budulinek/arduino-sensors-udp-gateway/arduino-sensors-udp-gateway/07-interfaces.ino

/**************************************************************************/
/*!
  @brief Initiates ethernet interface, if DHCP enabled, gets IP from DHCP,
  starts all servers (UDP, web server).
*/
/**************************************************************************/
void startEthernet() {
  if (ETH_RESET_PIN != 0) {
    pinMode(ETH_RESET_PIN, OUTPUT);
    digitalWrite(ETH_RESET_PIN, LOW);
    delay(25);
    digitalWrite(ETH_RESET_PIN, HIGH);
    delay(ETH_RESET_DELAY);
  }
#ifdef ENABLE_DHCP
  if (data.config.enableDhcp) {
    dhcpSuccess = Ethernet.begin(data.mac);
  }
  if (!data.config.enableDhcp || dhcpSuccess == false) {
    Ethernet.begin(data.mac, data.config.ip, data.config.dns, data.config.gateway, data.config.subnet);
  }
#else  /* ENABLE_DHCP */
  Ethernet.begin(data.mac, data.config.ip, {}, data.config.gateway, data.config.subnet);  // No DNS
#endif /* ENABLE_DHCP */
  W5100.setRetransmissionTime(TCP_RETRANSMISSION_TIMEOUT);
  W5100.setRetransmissionCount(TCP_RETRANSMISSION_COUNT);
  webServer = EthernetServer(data.config.webPort);
  Udp.begin(data.config.udpPort);
  webServer.begin();
#if MAX_SOCK_NUM > 4
  if (W5100.getChip() == 51) maxSockNum = 4;  // W5100 chip never supports more than 4 sockets
#endif
}

/**************************************************************************/
/*!
  @brief Resets Arduino (works only on AVR chips).
*/
/**************************************************************************/
void (*resetFunc)(void) = 0;  //declare reset function at address 0

/**************************************************************************/
/*!
  @brief Maintains DHCP lease.
*/
/**************************************************************************/
#ifdef ENABLE_DHCP
void maintainDhcp() {
  if (data.config.enableDhcp && dhcpSuccess == true) {  // only call maintain if initial DHCP request by startEthernet was successfull
    Ethernet.maintain();
  }
}
#endif /* ENABLE_DHCP */

/**************************************************************************/
/*!
  @brief Generate random MAC using pseudo random generator,
  bytes 0, 1 and 2 are static (MAC_START), bytes 3, 4 and 5 are generated randomly
*/
/**************************************************************************/
void generateMac() {
  // Marsaglia algorithm from https://github.com/RobTillaart/randomHelpers
  seed1 = 36969L * (seed1 & 65535L) + (seed1 >> 16);
  seed2 = 18000L * (seed2 & 65535L) + (seed2 >> 16);
  uint32_t randomBuffer = (seed1 << 16) + seed2; /* 32-bit random */
  memcpy(data.mac, MAC_START, 3);                // set first 3 bytes
  for (byte i = 0; i < 3; i++) {
    data.mac[i + 3] = randomBuffer & 0xFF;  // random last 3 bytes
    randomBuffer >>= 8;
  }
}

/**************************************************************************/
/*!
  @brief Write (update) data to Arduino EEPROM.
*/
/**************************************************************************/
void updateEeprom() {
#ifdef ENABLE_EXTENDED_WEBUI
  eepromTimer.sleep(EEPROM_INTERVAL * 60UL * 60UL * 1000UL);  // EEPROM_INTERVAL is in hours, sleep is in milliseconds!
#endif
  data.eepromWrites++;  // we assume that at least some bytes are written to EEPROM during EEPROM.update or EEPROM.put
  EEPROM.put(DATA_START, data);
}


uint32_t lastSocketUse[MAX_SOCK_NUM];
byte socketInQueue[MAX_SOCK_NUM];
/**************************************************************************/
/*!
  @brief Closes sockets which are waiting to be closed or which refuse to close,
  forwards sockets with data available for further processing by the webserver,
  disconnects (closes) sockets which are too old (idle for too long), opens
  new sockets if needed (and if available).
  From https://github.com/SapientHetero/Ethernet/blob/master/src/socket.cpp
*/
/**************************************************************************/
void manageSockets() {
  uint32_t maxAge = 0;         // the 'age' of the socket in a 'disconnectable' state that was last used the longest time ago
  byte oldest = MAX_SOCK_NUM;  // the socket number of the 'oldest' disconnectable socket
  byte webListening = MAX_SOCK_NUM;
  byte dataAvailable = MAX_SOCK_NUM;
  byte socketsAvailable = 0;
  SPI.beginTransaction(SPI_ETHERNET_SETTINGS);  // begin SPI transaction
  // look at all the hardware sockets, record and take action based on current states
  for (byte s = 0; s < maxSockNum; s++) {            // for each hardware socket ...
    byte status = W5100.readSnSR(s);                 //  get socket status...
    uint32_t sockAge = millis() - lastSocketUse[s];  // age of the current socket
    switch (status) {
      case SnSR::CLOSED:
        {
          socketsAvailable++;
        }
        break;
      case SnSR::LISTEN:
      case SnSR::SYNRECV:
        {
          lastSocketUse[s] = millis();
          webListening = s;
        }
        break;
      case SnSR::FIN_WAIT:
      case SnSR::CLOSING:
      case SnSR::TIME_WAIT:
      case SnSR::LAST_ACK:
        {
          socketsAvailable++;                  // socket will be available soon
          if (sockAge > TCP_DISCON_TIMEOUT) {  //     if it's been more than TCP_CLIENT_DISCON_TIMEOUT since disconnect command was sent...
            W5100.execCmdSn(s, Sock_CLOSE);    //	    send CLOSE command...
            lastSocketUse[s] = millis();       //       and record time at which it was sent so we don't do it repeatedly.
          }
        }
        break;
      case SnSR::ESTABLISHED:
      case SnSR::CLOSE_WAIT:
        {
          if (EthernetClient(s).available() > 0) {
            dataAvailable = s;
            lastSocketUse[s] = millis();
          } else {
            // remote host closed connection, our end still open
            if (status == SnSR::CLOSE_WAIT) {
              socketsAvailable++;               // socket will be available soon
              W5100.execCmdSn(s, Sock_DISCON);  //  send DISCON command...
              lastSocketUse[s] = millis();      //   record time at which it was sent...
                                                // status becomes LAST_ACK for short time
            } else if ((W5100.readSnPORT(s) == data.config.webPort && sockAge > WEB_IDLE_TIMEOUT) && sockAge > maxAge) {
              oldest = s;        //     record the socket number...
              maxAge = sockAge;  //      and make its age the new max age.
            }
          }
        }
        break;
      default:
        break;
    }
  }

  if (dataAvailable != MAX_SOCK_NUM) {
    EthernetClient client = EthernetClient(dataAvailable);
    recvWeb(client);
  }

  if (webListening == MAX_SOCK_NUM) {
    webServer.begin();
  }

  // If needed, disconnect socket that's been idle (ESTABLISHED without data recieved) the longest
  if (oldest != MAX_SOCK_NUM && socketsAvailable == 0 && webListening == MAX_SOCK_NUM) {
    disconSocket(oldest);
  }

  SPI.endTransaction();  // Serves to o release the bus for other devices to access it. Since the ethernet chip is the only device
}

/**************************************************************************/
/*!
  @brief Disconnect or close a socket.
  @param s Socket number.
*/
/**************************************************************************/
void disconSocket(byte s) {
  if (W5100.readSnSR(s) == SnSR::ESTABLISHED) {
    W5100.execCmdSn(s, Sock_DISCON);  // Sock_DISCON does not close LISTEN sockets
    lastSocketUse[s] = millis();      //   record time at which it was sent...
  } else {
    W5100.execCmdSn(s, Sock_CLOSE);  //  send DISCON command...
  }
}


/**************************************************************************/
/*!
  @brief Seed pseudorandom generator using  watch dog timer interrupt (works only on AVR).
  See https://sites.google.com/site/astudyofentropy/project-definition/timer-jitter-entropy-sources/entropy-library/arduino-random-seed
*/
/**************************************************************************/
void CreateTrulyRandomSeed() {
  seed1 = 0;
  nrot = 32;  // Must be at least 4, but more increased the uniformity of the produced seeds entropy.
  // The following five lines of code turn on the watch dog timer interrupt to create
  // the seed value
  cli();
  MCUSR = 0;
  _WD_CONTROL_REG |= (1 << _WD_CHANGE_BIT) | (1 << WDE);
  _WD_CONTROL_REG = (1 << WDIE);
  sei();
  while (nrot > 0)
    ;  // wait here until seed is created
  // The following five lines turn off the watch dog timer interrupt
  cli();
  MCUSR = 0;
  _WD_CONTROL_REG |= (1 << _WD_CHANGE_BIT) | (0 << WDE);
  _WD_CONTROL_REG = (0 << WDIE);
  sei();
}

ISR(WDT_vect) {
  nrot--;
  seed1 = seed1 << 8;
  seed1 = seed1 ^ TCNT1L;
}

// Preprocessor code for identifying microcontroller board
#if defined(TEENSYDUINO)
//  --------------- Teensy -----------------
#if defined(__AVR_ATmega32U4__)
#define BOARD F("Teensy 2.0")
#elif defined(__AVR_AT90USB1286__)
#define BOARD F("Teensy++ 2.0")
#elif defined(__MK20DX128__)
#define BOARD F("Teensy 3.0")
#elif defined(__MK20DX256__)
#define BOARD F("Teensy 3.2")  // and Teensy 3.1 (obsolete)
#elif defined(__MKL26Z64__)
#define BOARD F("Teensy LC")
#elif defined(__MK64FX512__)
#define BOARD F("Teensy 3.5")
#elif defined(__MK66FX1M0__)
#define BOARD F("Teensy 3.6")
#else
#define BOARD F("Unknown Board")
#endif
#else  // --------------- Arduino ------------------
#if defined(ARDUINO_AVR_ADK)
#define BOARD F("Arduino Mega Adk")
#elif defined(ARDUINO_AVR_BT)  // Bluetooth
#define BOARD F("Arduino Bt")
#elif defined(ARDUINO_AVR_DUEMILANOVE)
#define BOARD F("Arduino Duemilanove")
#elif defined(ARDUINO_AVR_ESPLORA)
#define BOARD F("Arduino Esplora")
#elif defined(ARDUINO_AVR_ETHERNET)
#define BOARD F("Arduino Ethernet")
#elif defined(ARDUINO_AVR_FIO)
#define BOARD F("Arduino Fio")
#elif defined(ARDUINO_AVR_GEMMA)
#define BOARD F("Arduino Gemma")
#elif defined(ARDUINO_AVR_LEONARDO)
#define BOARD F("Arduino Leonardo")
#elif defined(ARDUINO_AVR_LILYPAD)
#define BOARD F("Arduino Lilypad")
#elif defined(ARDUINO_AVR_LILYPAD_USB)
#define BOARD F("Arduino Lilypad Usb")
#elif defined(ARDUINO_AVR_MEGA)
#define BOARD F("Arduino Mega")
#elif defined(ARDUINO_AVR_MEGA2560)
#define BOARD F("Arduino Mega 2560")
#elif defined(ARDUINO_AVR_MICRO)
#define BOARD F("Arduino Micro")
#elif defined(ARDUINO_AVR_MINI)
#define BOARD F("Arduino Mini")
#elif defined(ARDUINO_AVR_NANO)
#define BOARD F("Arduino Nano")
#elif defined(ARDUINO_AVR_NG)
#define BOARD F("Arduino NG")
#elif defined(ARDUINO_AVR_PRO)
#define BOARD F("Arduino Pro")
#elif defined(ARDUINO_AVR_ROBOT_CONTROL)
#define BOARD F("Arduino Robot Ctrl")
#elif defined(ARDUINO_AVR_ROBOT_MOTOR)
#define BOARD F("Arduino Robot Motor")
#elif defined(ARDUINO_AVR_UNO)
#define BOARD F("Arduino Uno")
#elif defined(ARDUINO_AVR_YUN)
#define BOARD F("Arduino Yun")

// These boards must be installed separately:
#elif defined(ARDUINO_SAM_DUE)
#define BOARD F("Arduino Due")
#elif defined(ARDUINO_SAMD_ZERO)
#define BOARD F("Arduino Zero")
#elif defined(ARDUINO_ARC32_TOOLS)
#define BOARD F("Arduino 101")
#else
#define BOARD F("Unknown Board")
#endif
#endif
