budulinek/arduino-sensors-udp-gateway/(commit log)

2021-02-22 Support for Pt100, Pt1000 RTD sensors
    Support for Pt100, Pt1000 RTD sensors (MAX31865 module)
2021-02-22 Config overview in serial debug.
    Quick overview of configured sensors in serial debug.
